aidenzack/ECE445_Team78_Lab_Notebook/tanmayn2/tanmayn2_FinalProjectCAD/tanmayn2_FinalProjectCAD.kicad_pcb

## KiCad design tanmayn2/tanmayn2_FinalProjectCAD/tanmayn2_FinalProjectCAD.kicad_pcb (2026-02-20)

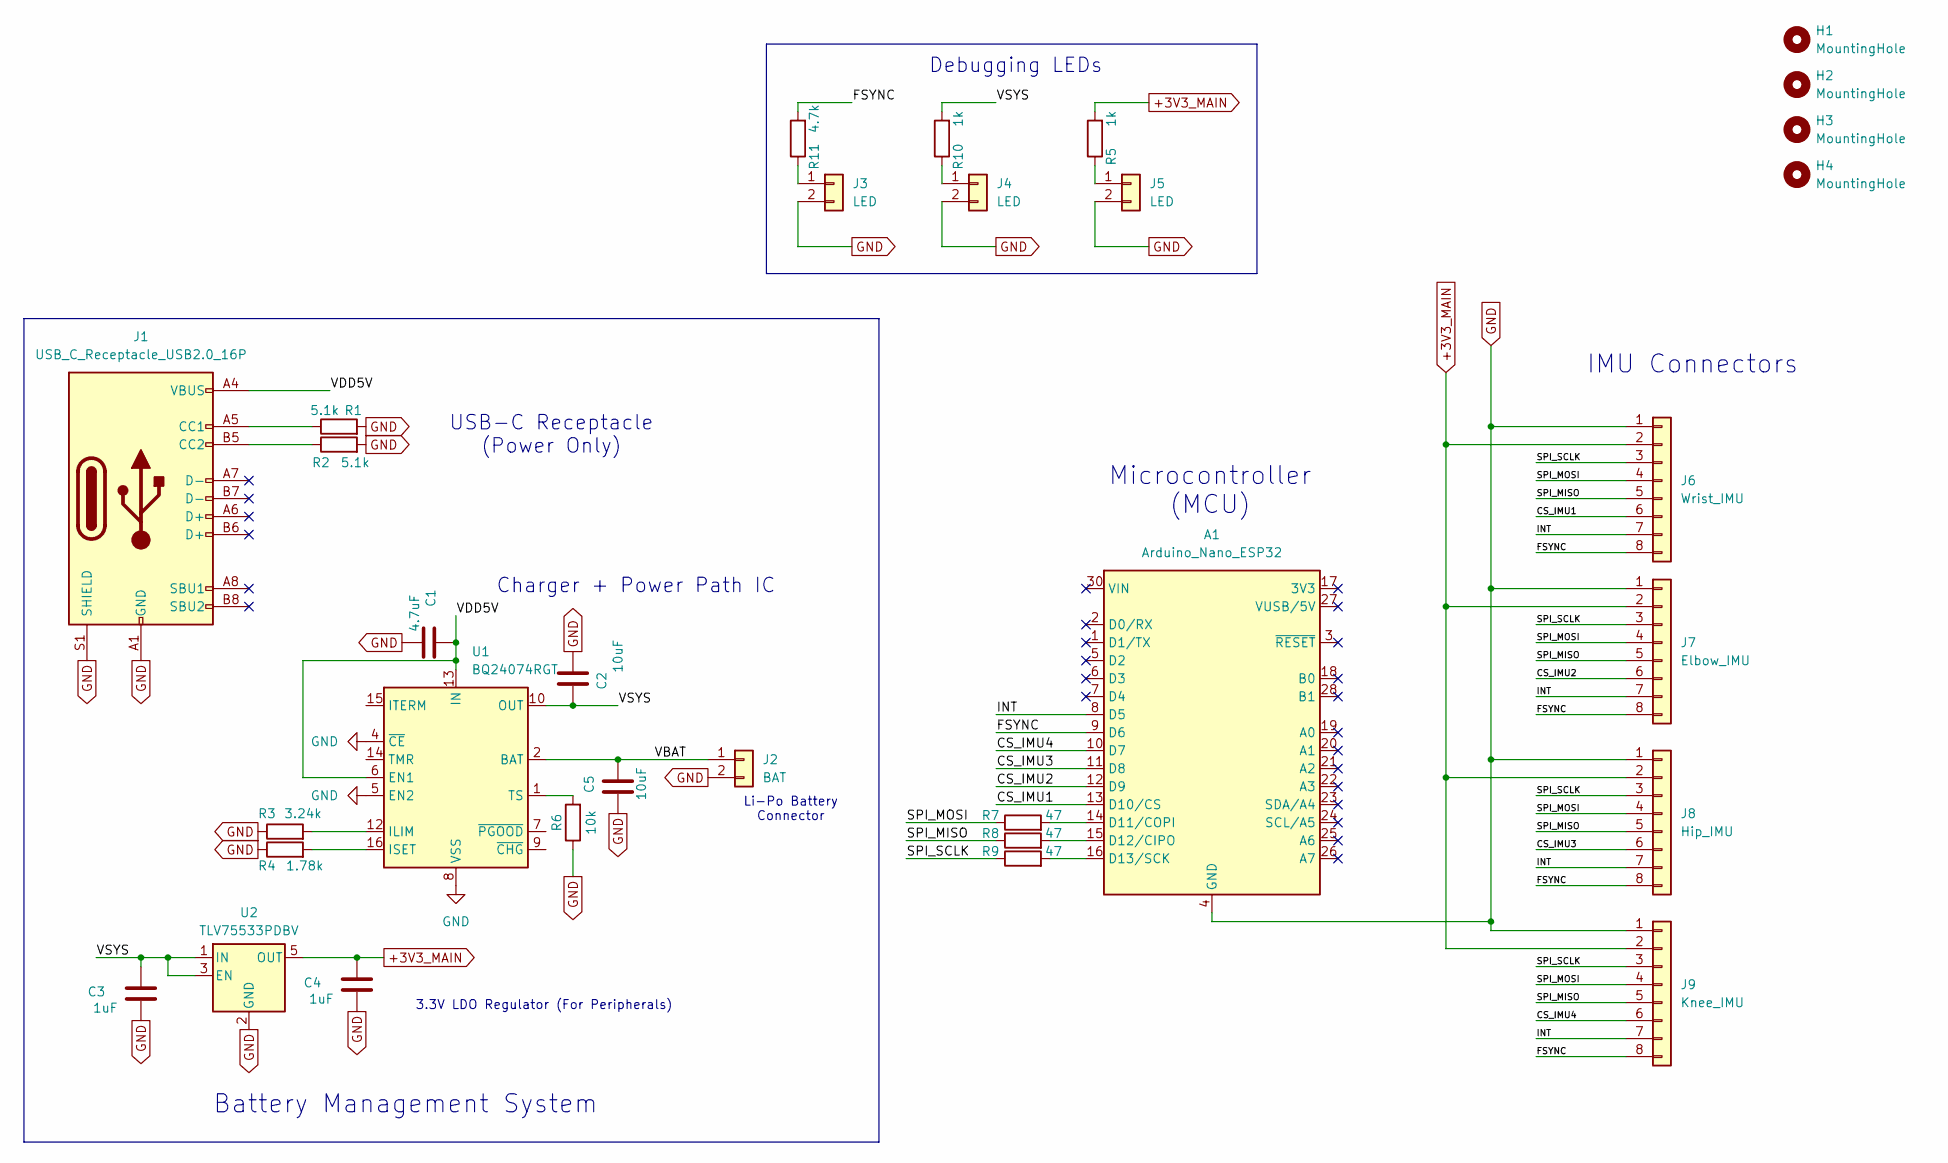
[picture p12: schematic tanmayn2_FinalProjectCAD.kicad_sch]

Parts:
A1: Arduino_Nano_ESP32; Arduino_Nano
C1: 4.7uF; C_0805_2012Metric_Pad1.18x1.45mm_HandSolder
C2, C5: 10uF; C_0805_2012Metric_Pad1.18x1.45mm_HandSolder
C3, C4: 1uF; C_0805_2012Metric_Pad1.18x1.45mm_HandSolder
H1, H2, H3, H4: MountingHole; MountingHole_3.2mm_M3
J1: USB_C_Receptacle_USB2.0_16P; USB_C_Receptacle_Molex_105450-0101
J2: BAT; Molex_KK-254_AE-6410-02A_1x02_P2.54mm_Vertical
J3, J4, J5: LED; Molex_KK-254_AE-6410-02A_1x02_P2.54mm_Vertical
J6: Wrist_IMU; Molex_KK-254_AE-6410-08A_1x08_P2.54mm_Vertical
J7: Elbow_IMU; Molex_KK-254_AE-6410-08A_1x08_P2.54mm_Vertical
J8: Hip_IMU; Molex_KK-254_AE-6410-08A_1x08_P2.54mm_Vertical
J9: Knee_IMU; Molex_KK-254_AE-6410-08A_1x08_P2.54mm_Vertical
R1, R2: 5.1k; R_0805_2012Metric_Pad1.20x1.40mm_HandSolder
R3: 3.24k; R_0805_2012Metric_Pad1.20x1.40mm_HandSolder
R4: 1.78k; R_0805_2012Metric_Pad1.20x1.40mm_HandSolder
R5, R10: 1k; R_0805_2012Metric_Pad1.20x1.40mm_HandSolder
R6: 10k; R_0805_2012Metric_Pad1.20x1.40mm_HandSolder
R7, R8, R9: 47; R_0805_2012Metric_Pad1.20x1.40mm_HandSolder
R11: 4.7k; R_0805_2012Metric_Pad1.20x1.40mm_HandSolder
U1: BQ24074RGT; VQFN-16-1EP_3x3mm_P0.5mm_EP1.6x1.6mm
U2: TLV75533PDBV; SOT-23-5

Connections:
+3V3_MAIN: C4.1, J6.2, J7.2, J8.2, J9.2, R5.2, U2.5 (OUT)
/CS_IMU1: A1.13 (D10/CS), J6.6
/CS_IMU2: A1.12 (D9), J7.6
/CS_IMU3: A1.11 (D8), J8.6
/CS_IMU4: A1.10 (D7), J9.6
/FSYNC: A1.9 (D6), J6.8, J7.8, J8.8, J9.8, R11.2
/INT: A1.8 (D5), J6.7, J7.7, J8.7, J9.7
/SPI_MISO: J6.5, J7.5, J8.5, J9.5, R8.1
/SPI_MOSI: J6.4, J7.4, J8.4, J9.4, R7.1
/SPI_SCLK: J6.3, J7.3, J8.3, J9.3, R9.1
/VBAT: C5.1, J2.1, U1.2 (BAT), U1.3 (BAT)
/VDD5V: C1.1, J1.A4 (VBUS), J1.A9 (VBUS), J1.B4 (VBUS), J1.B9 (VBUS), U1.6 (EN1), U1.13 (IN)
/VSYS: C2.1, C3.1, R10.2, U1.10 (OUT), U1.11 (OUT), U2.1 (IN), U2.3 (EN)
GND: A1.4 (GND), A1.29 (GND), C1.2, C2.2, C3.2, C4.2, C5.2, J1.A1 (GND), J1.A12 (GND), J1.B1 (GND), J1.B12 (GND), J1.S1 (SHIELD), J2.2, J3.2, J4.2, J5.2, J6.1, J7.1, J8.1, J9.1, R1.2, R2.2, R3.1, R4.1, R6.1, U1.4 (~CE), U1.5 (EN2), U1.8 (VSS), U1.17 (VSS), U2.2 (GND)
unnamed: A1.14 (D11/COPI), R7.2
unnamed: A1.15 (D12/CIPO), R8.2
unnamed: A1.16 (D13/SCK), R9.2
unnamed: J1.A5 (CC1), R1.1
unnamed: J1.B5 (CC2), R2.1
unnamed: J3.1, R11.1
unnamed: J4.1, R10.1
unnamed: J5.1, R5.1
unnamed: R3.2, U1.12 (ILIM)
unnamed: R4.2, U1.16 (ISET)
unnamed: R6.2, U1.1 (TS)

Notes on the sheet:
3.3V LDO Regulator (For Peripherals)
Li-Po Battery Connector
Charger + Power Path IC
IMU Connectors
USB-C Receptacle (Power Only)
Debugging LEDs
Microcontroller (MCU)
Battery Management System

Board: 2 copper layers, 32 parts (0 on the bottom side), 25 nets, no tracks yet.
